soggybag/Mutant-SMD/docs/MutantSMD_render_bottom.png

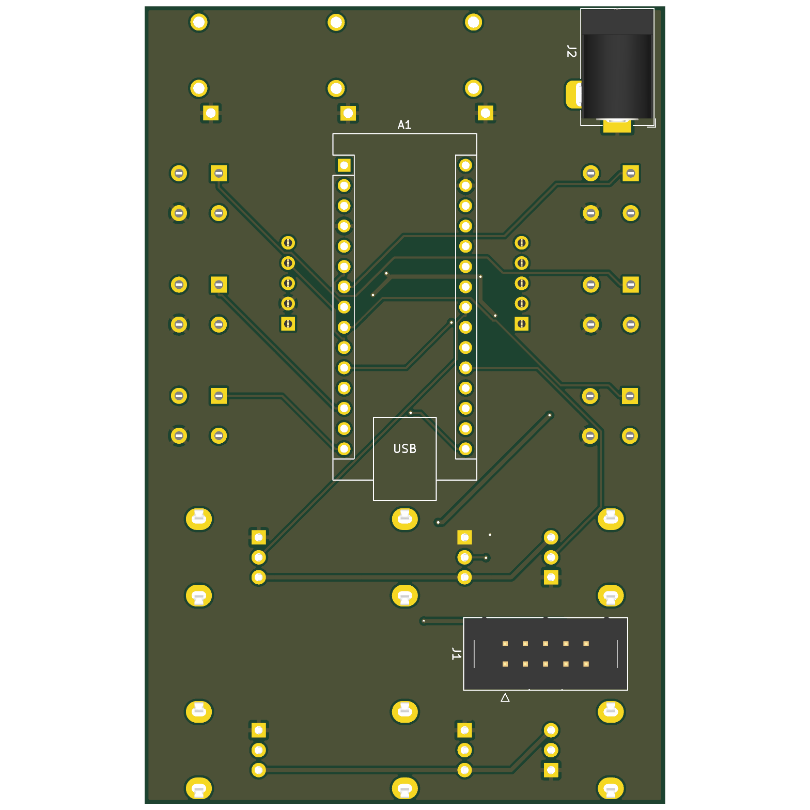
docs/MutantSMD_render_bottom.png
