soggybag/Mutant-SMD/docs/MutantSMD_render_top.png

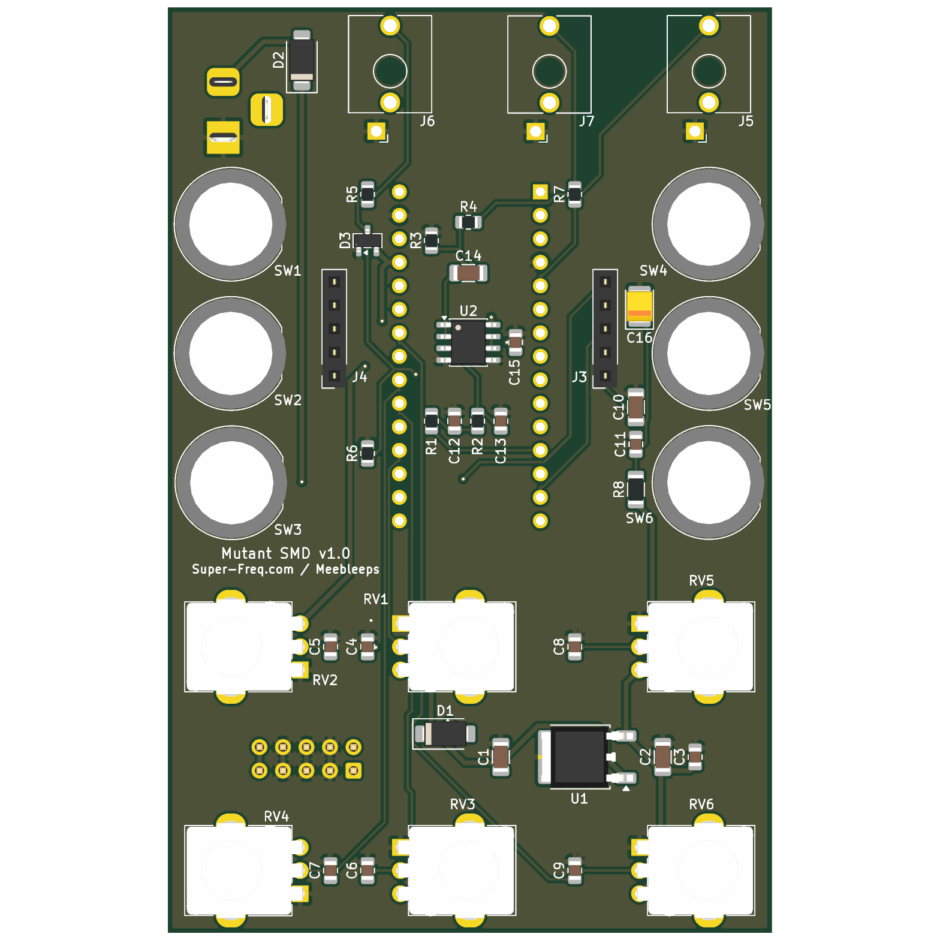
docs/MutantSMD_render_top.png
