soggybag/Mutant-SMD/3dmodels/SW_Push_Round_D12mm_DAIER_TSL-A064.step

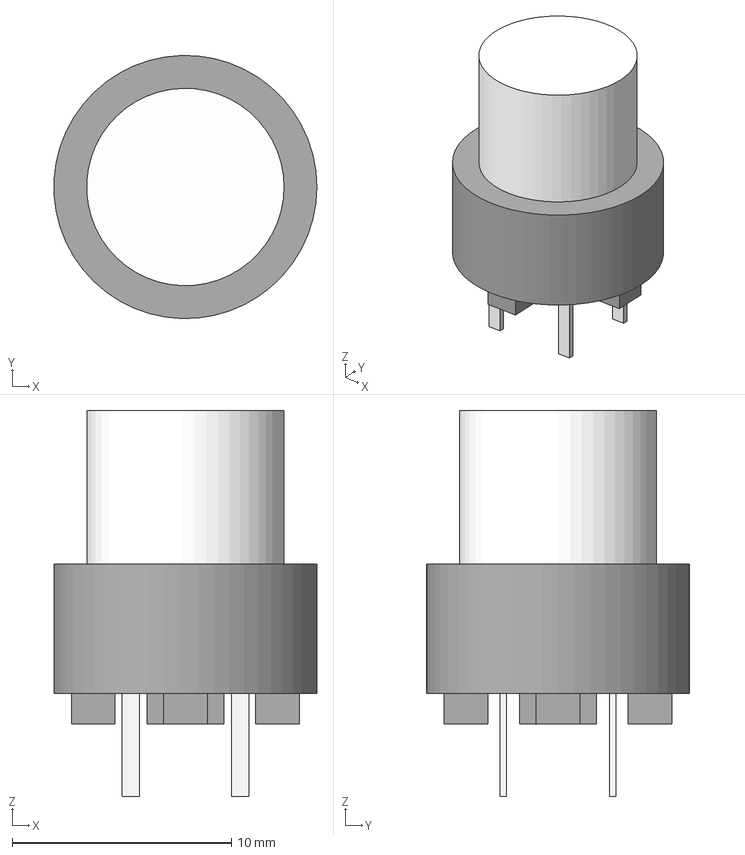
[picture p3: CAD file, 2026-10-12]
3dmodels/SW_Push_Round_D12mm_DAIER_TSL-A064.step
12.0 x 12.0 x 17.6 mm
cap
pins
