soggybag/Mutant-SMD/docs/MutantSMD_schematic.pdf

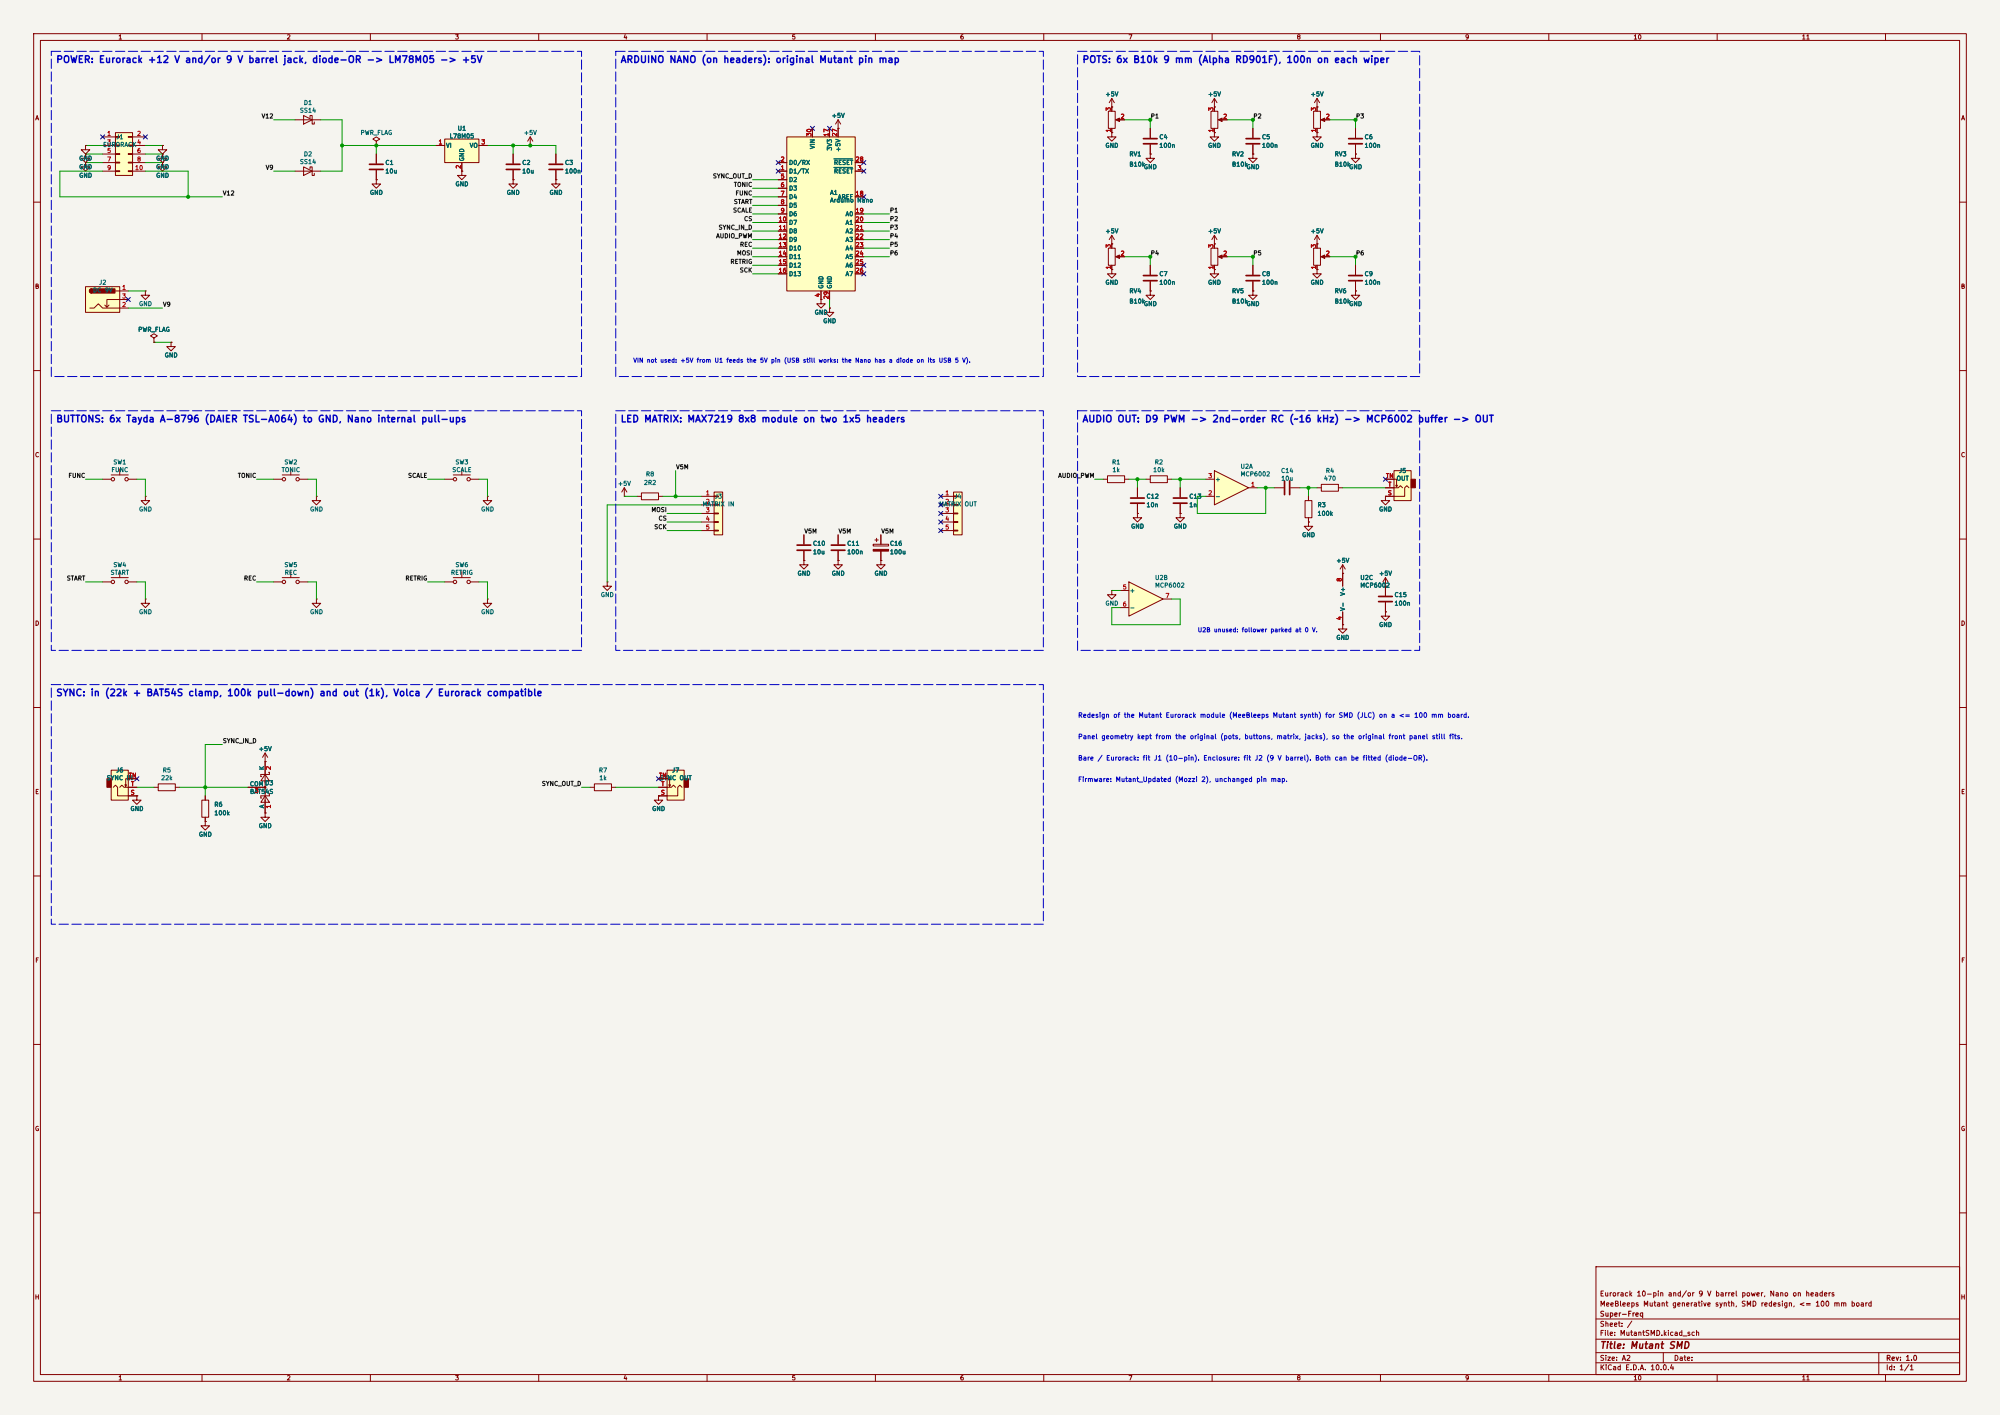
[picture p5: page 1]

POTS: 6x B10k 9 mm (Alpha RD901F), 100n on each wiper

VIN not used: +5V from U1 feeds the 5V pin (USB still works: the Nano has a diode on its USB 5 V).

LED MATRIX: MAX7219 8x8 module on two 1x5 headers

SYNC: in (22k + BAT54S clamp, 100k pull-down) and out (1k), Volca / Eurorack compatible

Panel geometry kept from the original (pots, buttons, matrix, jacks), so the original front panel still fits. Redesign of the Mutant Eurorack module (MeeBleeps Mutant synth) for SMD (JLC) on a <= 100 mm board.

Bare / Eurorack: fit J1 (10-pin). Enclosure: fit J2 (9 V barrel). Both can be fitted (diode-OR). Firmware: Mutant_Updated (Mozzi 2), unchanged pin map.

Eurorack 10-pin and/or 9 V barrel power, Nano on headers
MeeBleeps Mutant generative synth, SMD redesign, <= 100 mm board
Super-Freq
Sheet: /
File: MutantSMD.kicad_sch
Title: Mutant SMD

Size: A2 | Rev: 1.0
KiCad E.D.A. 10.0.4 | Id: 1/1
