soggybag/Mutant-SMD/archive/v1.0/MutantSMD_board_back.pdf

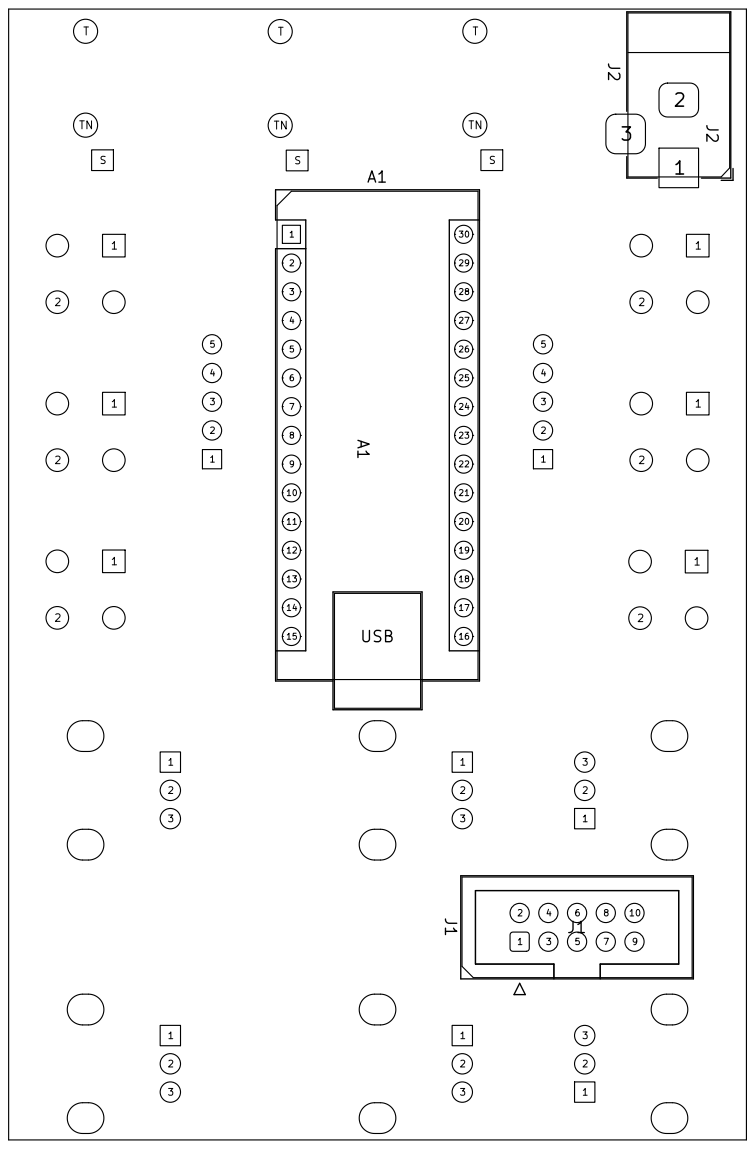
[picture p6: page 1]

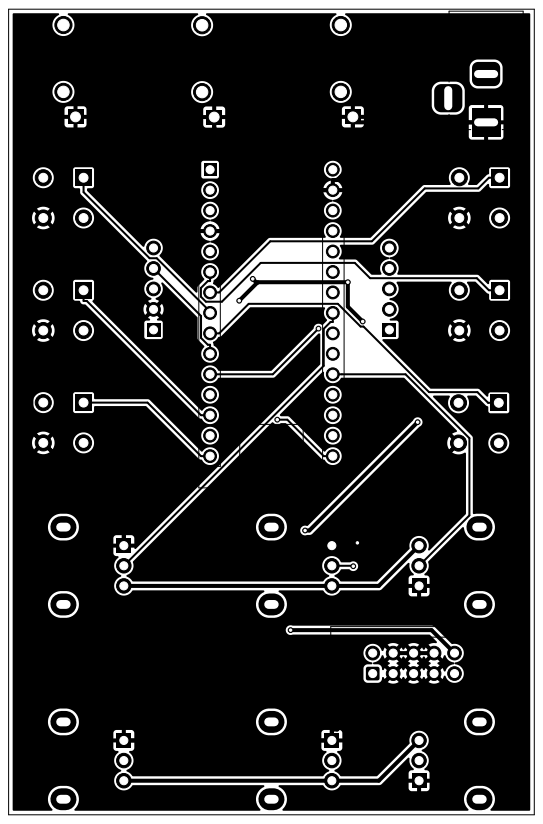
[picture p7: page 2]
