soggybag/Mutant-SMD/archive/v1.0/MutantSMD_board_front.pdf

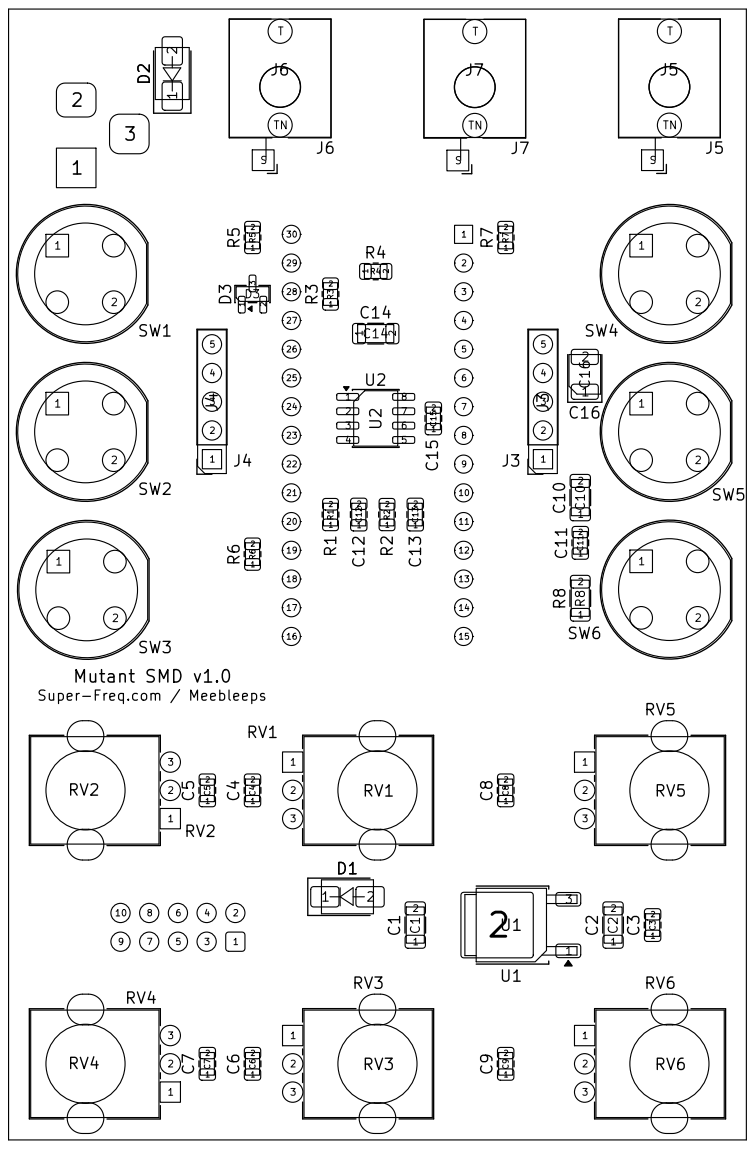
[picture p8: page 1]

30 Super-Freq.com / Meebleeps

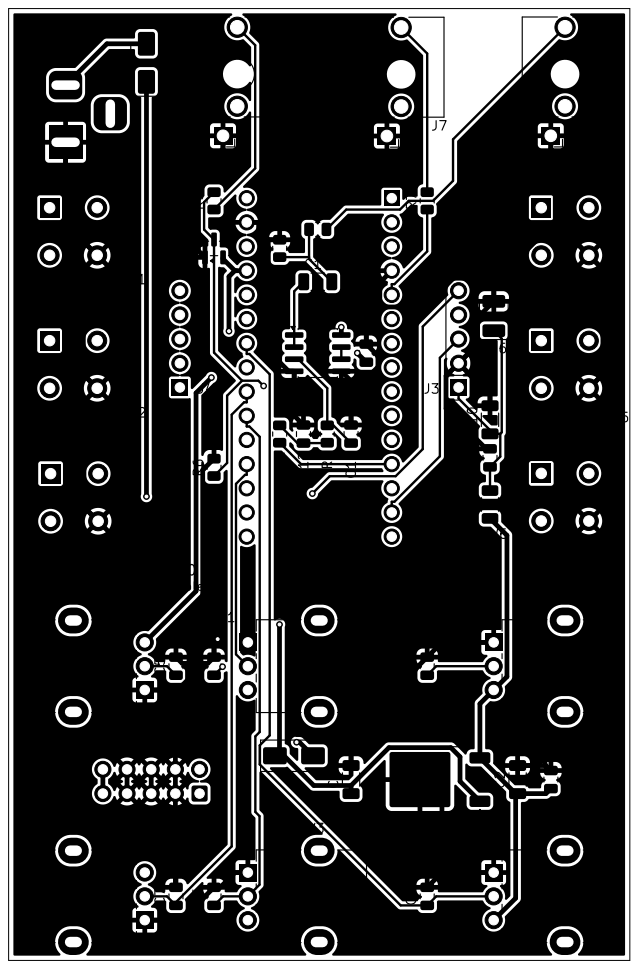
[picture p9: page 2]

Super-Freq.com / Meebleeps
