soggybag/Mutant-SMD/MutantSMD.kicad_pcb

## KiCad design MutantSMD.kicad_pcb (2026-10-20)

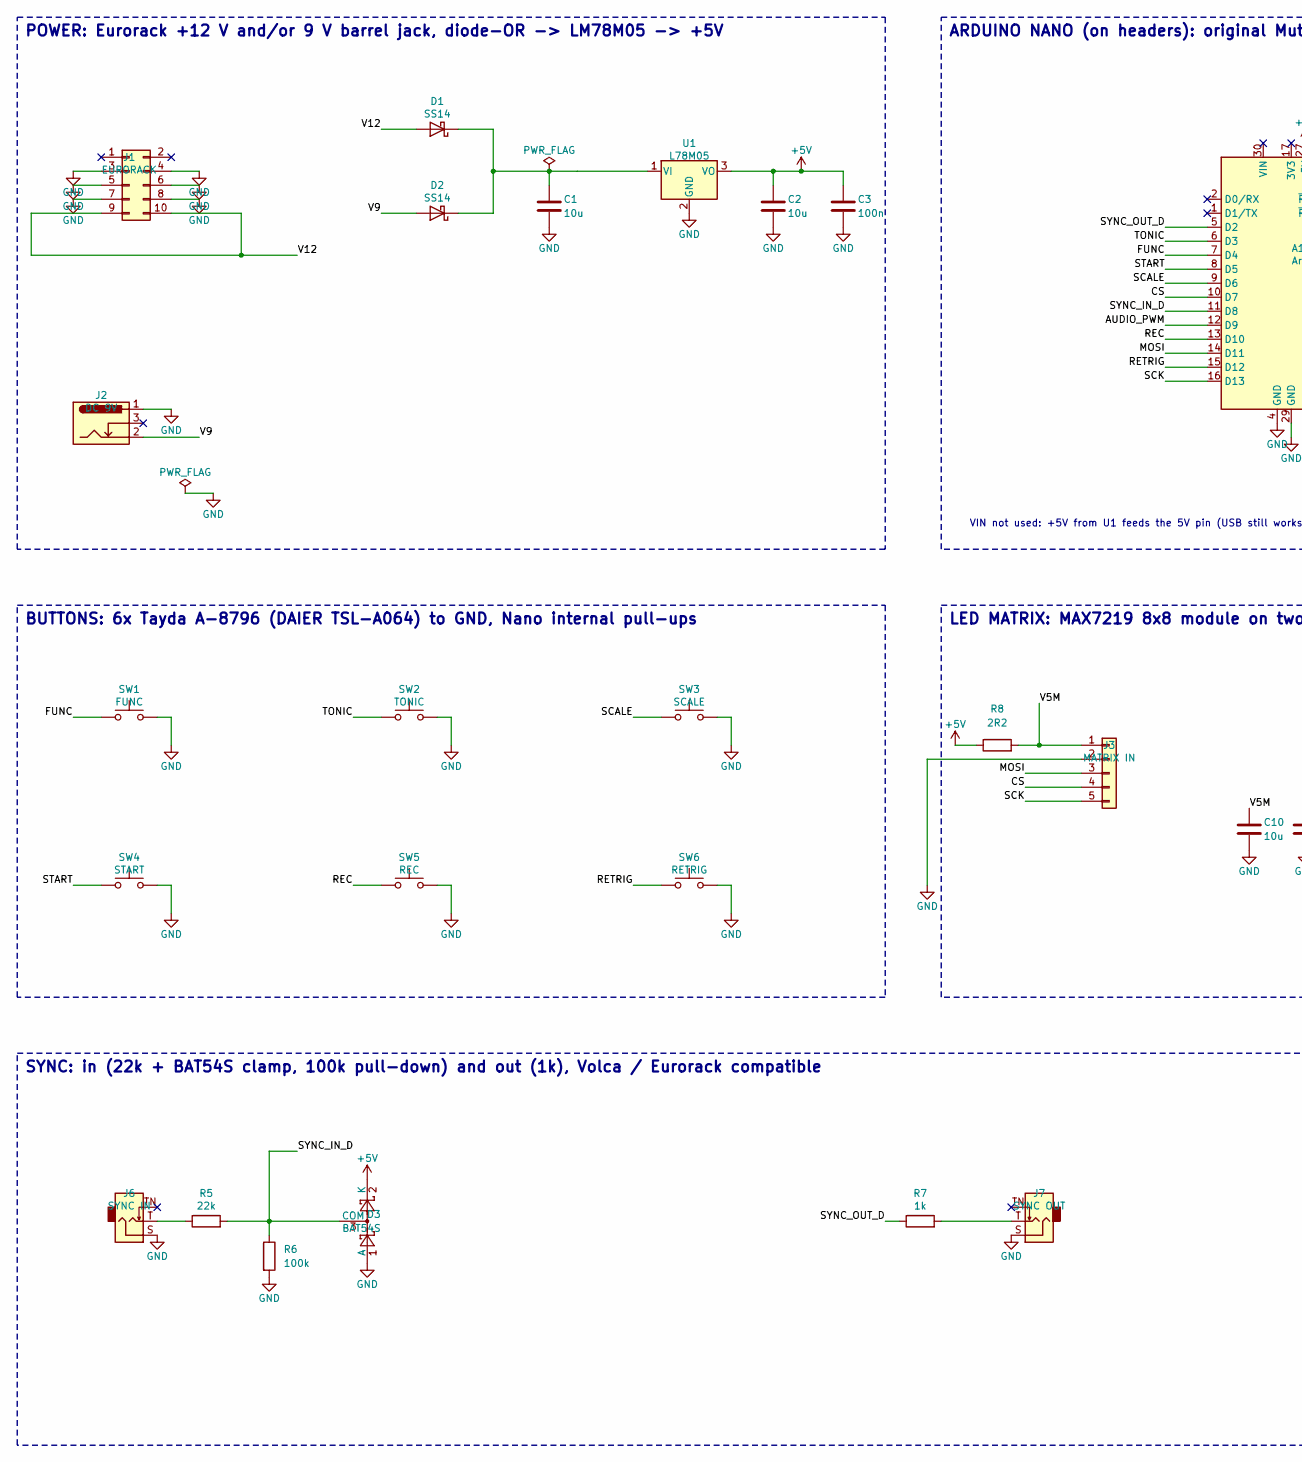
[picture p10: schematic MutantSMD.kicad_sch, Mutant SMD, part in row 1, column 1]

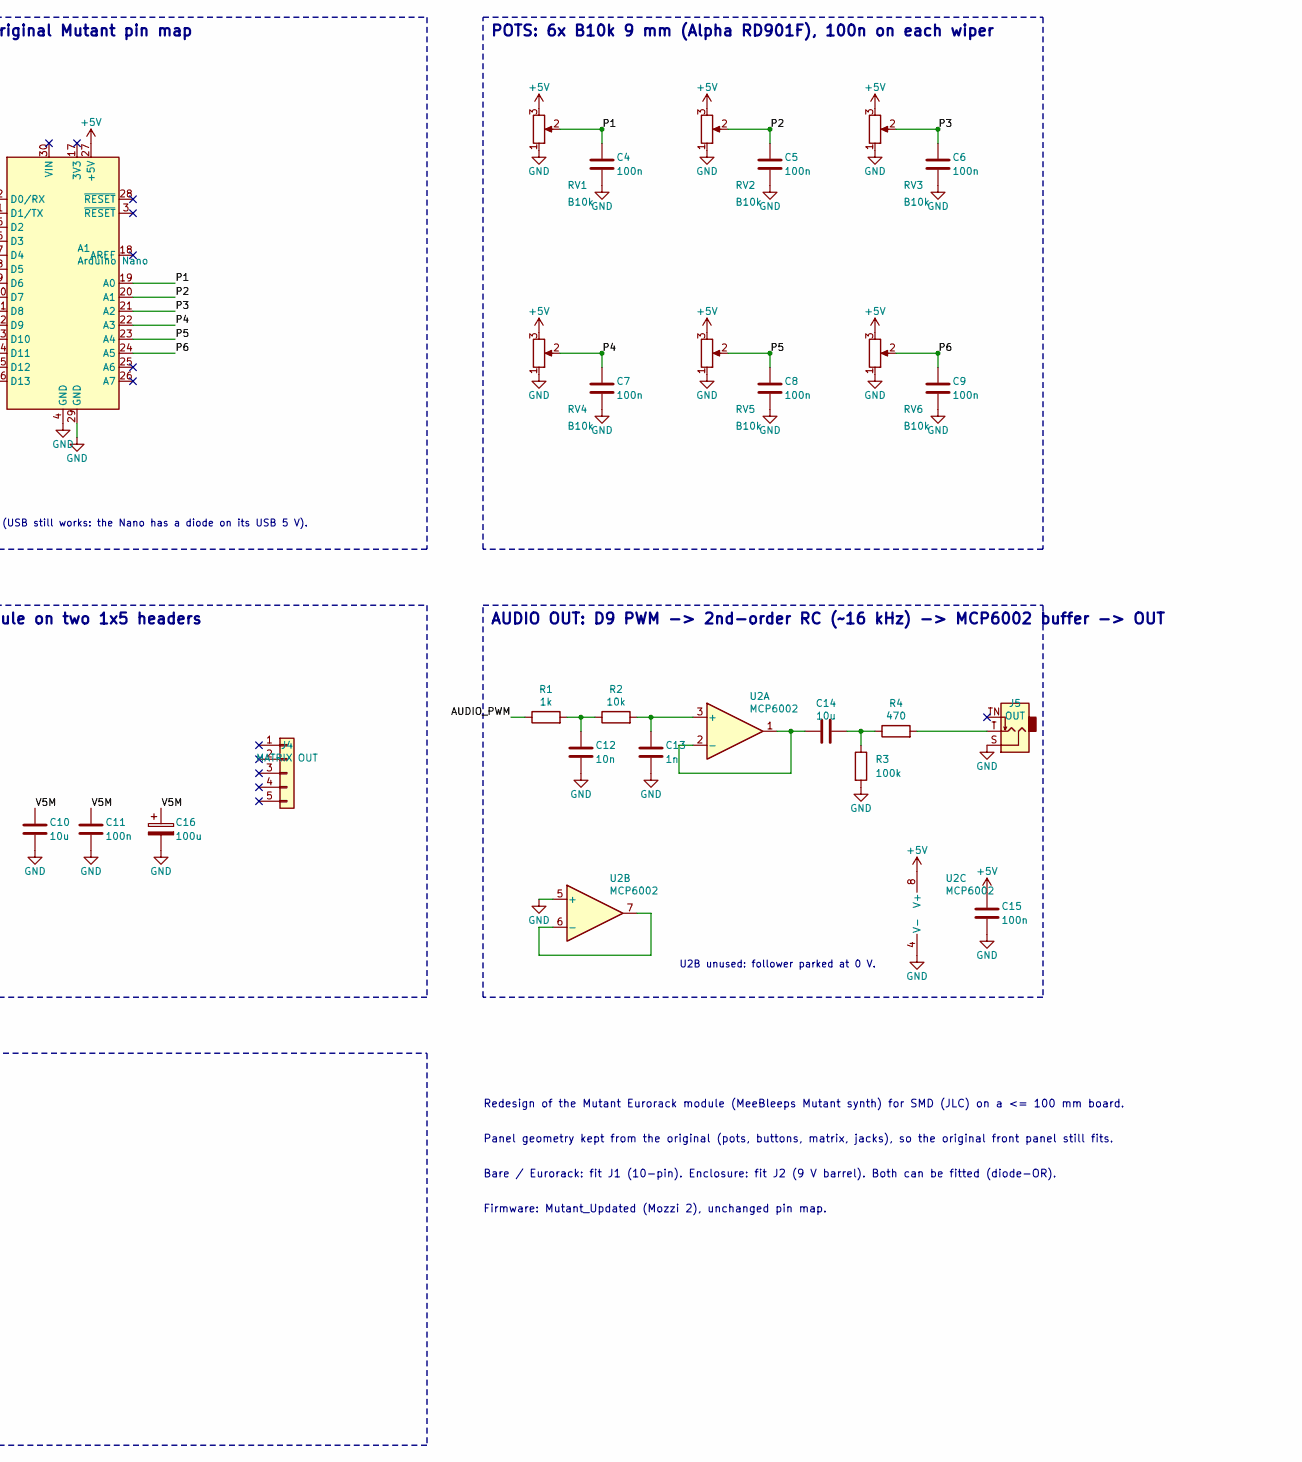
[picture p11: schematic MutantSMD.kicad_sch, Mutant SMD, part in row 1, column 2]

Parts:
A1: Arduino Nano; Arduino_Nano
C1, C2, C10, C14: 10u; C_1206_3216Metric; LCSC C13585
C3, C4, C5, C6, C7, C8, C9, C11, C15: 100n; C_0805_2012Metric; LCSC C49678
C12: 10n; C_0805_2012Metric; LCSC C1710
C13: 1n; C_0805_2012Metric; LCSC C46653
C16: 100u; CP_EIA-3528-21_Kemet-B; LCSC C122271
D1, D2: SS14; D_SMA; LCSC C2480
D3: BAT54S; SOT-23; LCSC C19726
J1: EURORACK; IDC-Header_2x05_P2.54mm_Vertical
J2: DC 9V; BarrelJack_Horizontal
J3: MATRIX IN; PinSocket_1x05_P2.54mm_Vertical
J4: MATRIX OUT; PinSocket_1x05_P2.54mm_Vertical
J5: OUT; Jack_3.5mm_QingPu_WQP-PJ398SM_Vertical_CircularHoles
J6: SYNC IN; Jack_3.5mm_QingPu_WQP-PJ398SM_Vertical_CircularHoles
J7: SYNC OUT; Jack_3.5mm_QingPu_WQP-PJ398SM_Vertical_CircularHoles
R1, R7: 1k; R_0805_2012Metric; LCSC C17513
R2: 10k; R_0805_2012Metric; LCSC C17414
R3, R6: 100k; R_0805_2012Metric; LCSC C149504
R4: 470; R_0805_2012Metric; LCSC C17710
R5: 22k; R_0805_2012Metric; LCSC C17560
R8: 2R2; R_1206_3216Metric; LCSC C25369
RV1, RV2, RV3, RV4, RV5, RV6: B10k; Potentiometer_Alpha_RD901F-40-00D_Single_Vertical
SW1: FUNC; SW_Push_Round_D12mm_P5.00mm_DAIER_TSL-A064
SW2: TONIC; SW_Push_Round_D12mm_P5.00mm_DAIER_TSL-A064
SW3: SCALE; SW_Push_Round_D12mm_P5.00mm_DAIER_TSL-A064
SW4: START; SW_Push_Round_D12mm_P5.00mm_DAIER_TSL-A064
SW5: REC; SW_Push_Round_D12mm_P5.00mm_DAIER_TSL-A064
SW6: RETRIG; SW_Push_Round_D12mm_P5.00mm_DAIER_TSL-A064
U1: L78M05; TO-252-2; LCSC C58069
U2: MCP6002; SOIC-8_3.9x4.9mm_P1.27mm; LCSC C7377

Connections:
+5V: A1.27 (+5V), C2.1, C3.1, C15.1, D3.2 (K), R8.1, RV1.3, RV2.3, RV3.3, RV4.3, RV5.3, RV6.3, U1.3 (VO), U2.8 (V+)
/AUDIO_PWM: A1.12 (D9), R1.1
/CS: A1.10 (D7), J3.4
/FUNC: A1.7 (D4), SW1.1
/MOSI: A1.14 (D11), J3.3
/P1: A1.19 (A0), C4.1, RV1.2
/P2: A1.20 (A1), C5.1, RV2.2
/P3: A1.21 (A2), C6.1, RV3.2
/P4: A1.22 (A3), C7.1, RV4.2
/P5: A1.23 (A4), C8.1, RV5.2
/P6: A1.24 (A5), C9.1, RV6.2
/REC: A1.13 (D10), SW5.1
/RETRIG: A1.15 (D12), SW6.1
/SCALE: A1.9 (D6), SW3.1
/SCK: A1.16 (D13), J3.5
/START: A1.8 (D5), SW4.1
/SYNC_IN_D: A1.11 (D8), D3.3 (COM), R5.2, R6.1
/SYNC_OUT_D: A1.5 (D2), R7.1
/TONIC: A1.6 (D3), SW2.1
/V5M: C10.1, C11.1, C16.1, J3.1, R8.2
/V9: D2.2 (A), J2.2
/V12: D1.2 (A), J1.9, J1.10
unnamed: C12.1, R1.2, R2.1
unnamed: C14.2, R3.1, R4.1
unnamed: J5.T, R4.2
unnamed: J6.T, R5.1
unnamed: J7.T, R7.2
unnamed: C13.1, R2.2, U2.3 (+)
unnamed: C14.1, U2.1, U2.2 (-)
unnamed: U2.6 (-), U2.7

Notes on the sheet:
POWER: Eurorack +12 V and/or 9 V barrel jack, diode-OR -> LM78M05 -> +5V
ARDUINO NANO (on headers): original Mutant pin map
VIN not used: +5V from U1 feeds the 5V pin (USB still works: the Nano has a diode on its USB 5 V).
POTS: 6x B10k 9 mm (Alpha RD901F), 100n on each wiper
BUTTONS: 6x Tayda A-8796 (DAIER TSL-A064) to GND, Nano internal pull-ups
LED MATRIX: MAX7219 8x8 module on two 1x5 headers
AUDIO OUT: D9 PWM -> 2nd-order RC (~16 kHz) -> MCP6002 buffer -> OUT
U2B unused: follower parked at 0 V.
SYNC: in (22k + BAT54S clamp, 100k pull-down) and out (1k), Volca / Eurorack compatible
Redesign of the Mutant Eurorack module (MeeBleeps Mutant synth) for SMD (JLC) on a <= 100 mm board.
Panel geometry kept from the original (pots, buttons, matrix, jacks), so the original front panel still fits.
Bare / Eurorack: fit J1 (10-pin). Enclosure: fit J2 (9 V barrel). Both can be fitted (diode-OR).
Firmware: Mutant_Updated (Mozzi 2), unchanged pin map.

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
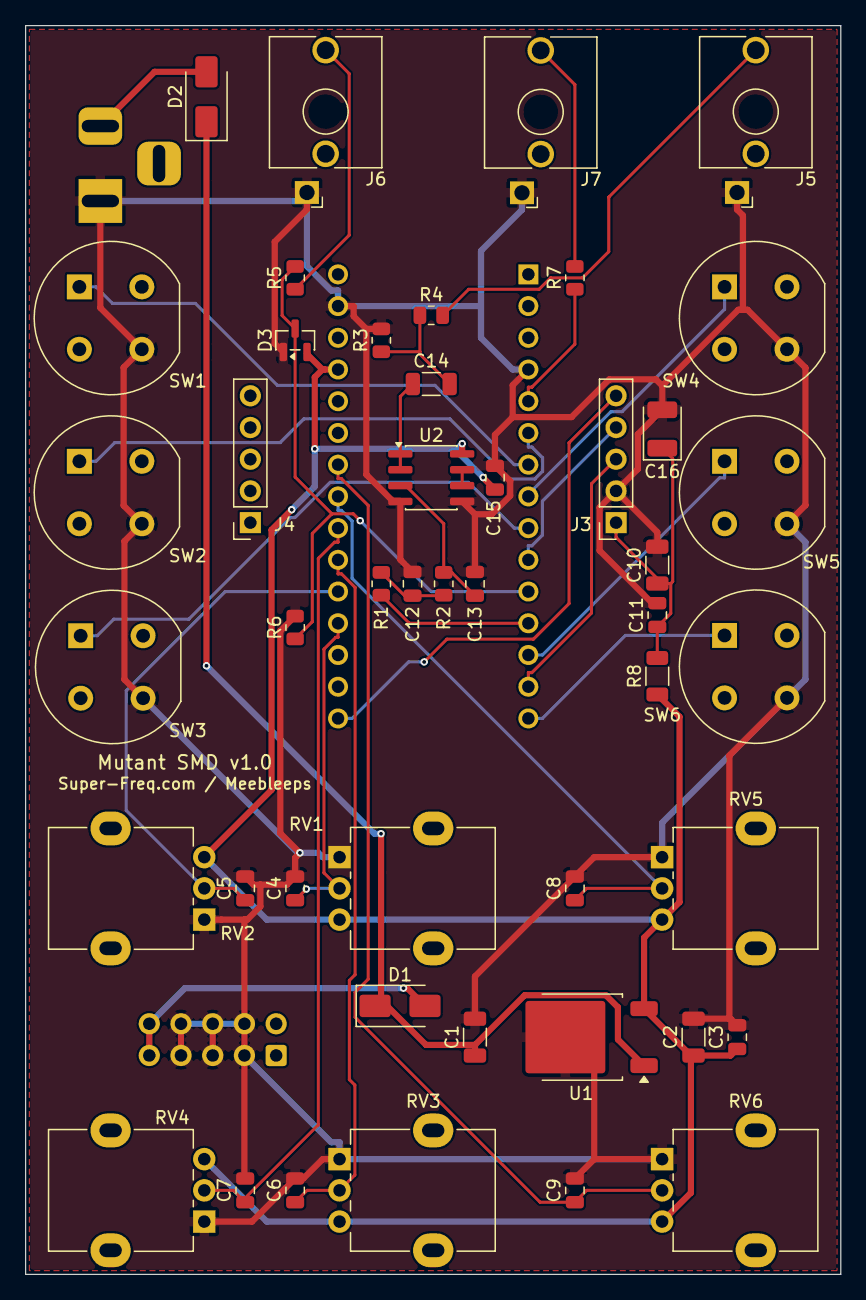
[picture p12: board MutantSMD.kicad_pcb from above]

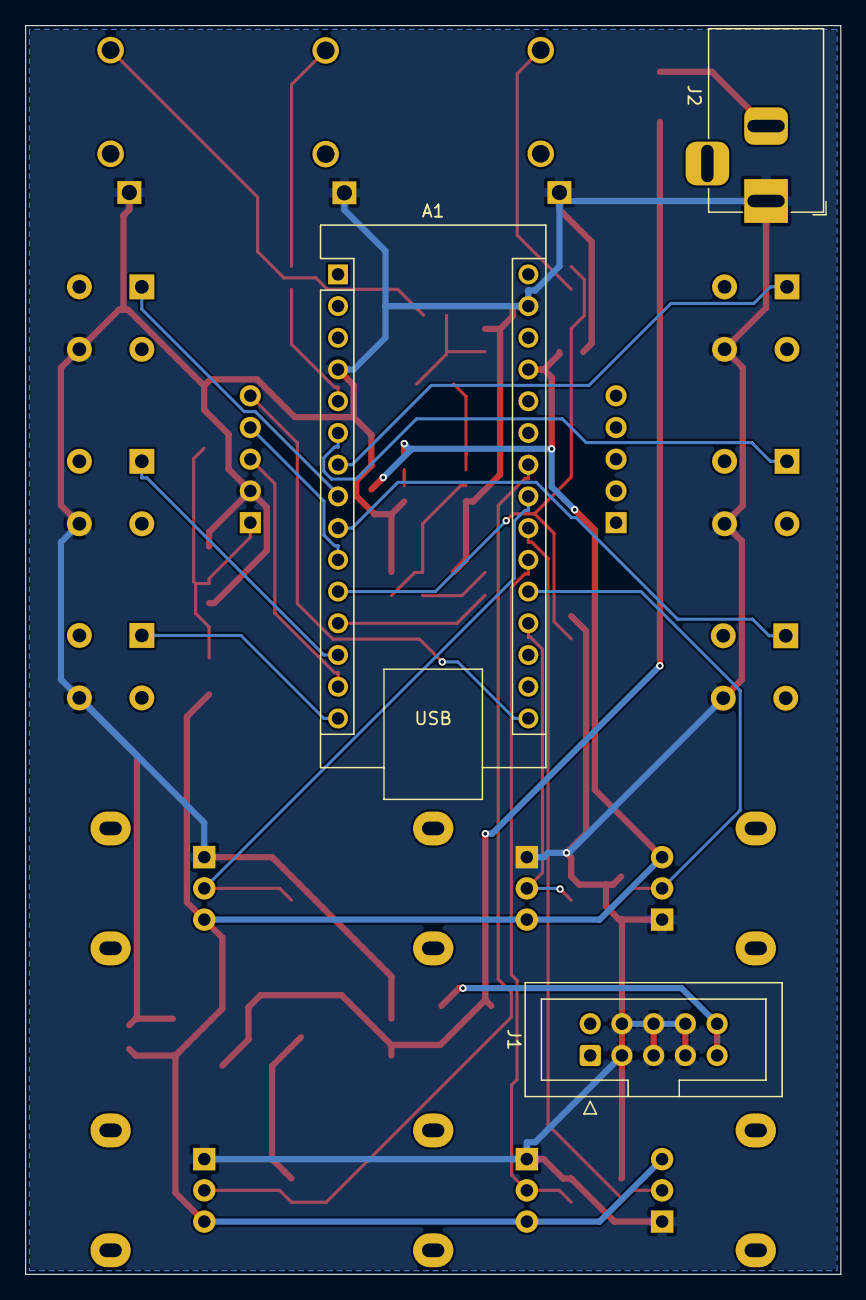
[picture p13: board MutantSMD.kicad_pcb from below]

Board: 2 copper layers, 65.3 x 100.0 mm, 49 parts (3 on the bottom side), 32 nets.
