soggybag/Mutant-SMD/(commit log)

2026-10-12 Mutant SMD v0.1: schematic and routed PCB
    Redesign of the MeeBleeps Mutant generative synth (from the
    Mutant_Generative_Arduino_Synth Eurorack project) for JLC SMD assembly:
    - board 65.3 x 100 mm (was 65.3 x 106.4), usable bare, behind a 13 HP
    Eurorack panel, or in an enclosure; original control positions kept so the
    original front panel still fits
    - power: Eurorack 10-pin (+12 V) and/or 9 V barrel jack, SS14 diode-OR,
    LM78M05 DPAK feeding the Nano's 5V pin
    - Arduino Nano on headers (same pin map, Mutant_Updated firmware unchanged),
    plug-in MAX7219 matrix module, Tayda A-8796 buttons, RD901F 9 mm pots
    - sync in clamped (BAT54S) for Eurorack gates, 1k on sync out, buffered
    audio out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
    [MutantSMD.kicad_pcb, MutantSMD.kicad_sch, SW_Push_Round_D12mm_DAIER_TSL-A064.step, pot_RD901F_T18_shaft_alpha_9mm_vertical.step]
2026-10-12 Add LCSC numbers to all SMD parts; 10u caps to 50 V (C13585), U1 L78M05ABDT-TR (C58069)
    Re-linked board footprints to the regenerated schematic; routing unchanged, ERC/DRC/parity clean.
    [MutantSMD.kicad_pcb, MutantSMD.kicad_sch]
2026-10-19 Mutant SMD v1.0: board text (name, Super-Freq.com, Meebleeps credit), your Dwgs circle; ready for fab
    [MutantSMD.kicad_pcb]
2026-10-19 Matrix supply filter: R8 2R2 + C16 100u tantalum feed the MAX7219 module on its own V5M rail; re-routed; docs, renders
    The module's multiplex current pulses no longer modulate the Nano's 5 V (= the D9 audio PWM high level).
    Schematic rev 1.0 to match the silkscreen. Adds scripts/pcb_fields.py (LCSC/description fields from the netlist).
    [MutantSMD.kicad_pcb, MutantSMD.kicad_sch]
2026-10-20 JLC rotation offsets: U2 MCP6002 270, D3 BAT54S 180 (positions regenerated)
    [MutantSMD.kicad_pcb, MutantSMD.kicad_sch]
2026-10-20 Archive v1.0: schematic and board PDFs, renders, interactive BOM, parts list, docs and fab files
    [MutantSMD_hand_solder.csv, bom.csv, designators.csv, parts.csv, positions.csv]
